Fihdi/LIN/LIN-BOM.csv

Reference | Qty | Value | Footprint
C101,C102 | 2 | 1u | Capacitor_SMD:C_1206_3216Metric
C104,C105 | 2 | 100n | Capacitor_SMD:C_1206_3216Metric
D102,D103 | 2 | 1N4148 | Diode_SMD:D_SOD-323_HandSoldering
D104 | 1 | LED | LED_THT:LED_D5.0mm
J1 | 1 | Conn_02x05_Odd_Even | Connector_IDC:IDC-Header_2x05_P2.54mm_Vertical
J102,J103,J104 | 3 | AudioJack2 | Library:MonoTRS
J105 | 1 | AudioJack3 | Library:StereoTRS
Q101 | 1 | BC857 | Package_TO_SOT_SMD:SOT-23
R5,R13 | 2 | 47k | Resistor_SMD:R_1206_3216Metric
R101,R104 | 2 | 100k | Resistor_SMD:R_1206_3216Metric
R102,R103,R105,R106,R111,R113 | 6 | 1k | Resistor_SMD:R_1206_3216Metric
R108,R109 | 2 | 4k7 | Resistor_SMD:R_1206_3216Metric
R110,R112 | 2 | 500k | Resistor_SMD:R_1206_3216Metric
R114 | 1 | 2k2 | Resistor_SMD:R_1206_3216Metric
RV1,RV2 | 2 | 100k | Potentiometer_THT:Potentiometer_Alpha_RD901F-40-00D_Single_Vertical
U101 | 1 | LM13700 | Package_SO:SOIC-16_3.9x9.9mm_P1.27mm
U102 | 1 | TL072 | Package_SO:SOIC-8_3.9x4.9mm_P1.27mm
