Fihdi/LIN/LIN-AB-Board-BOM.xlsx

 |  |  | LIN AB-Board BOM
Item # | *Designator | *Qty | Manufacturer | *Mfg Part # | Description / Value | *Package/Footprint | Type | Your Instructions / Notes
1 | C101,C102 | 2 |  | C377070 | 1u | Capacitor_SMD:C_1206_3216Metric
2 | C104,C105 | 2 |  | C309030 | 100n | Capacitor_SMD:C_1206_3216Metric
3 | D102,D103 | 2 |  | C917117 | 1N4148 | Diode_SMD:D_SOD-323_HandSoldering
4 | D104 | 1 |  |  | LED | LED_THT:LED_D5.0mm |  | DNP
5 | J1 | 1 |  |  | Conn_02x05_Odd_Even | Connector_IDC:IDC-Header_2x05_P2.54mm_Vertical |  | DNP
6 | J102,J103,J104 | 3 |  |  | AudioJack2 | Library:MonoTRS |  | DNP
7 | J105 | 1 |  |  | AudioJack3 | Library:StereoTRS |  | DNP
8 | Q101 | 1 |  | C148244 | BC857 | Package_TO_SOT_SMD:SOT-23
9 | R5,R13 | 2 |  | C2907507 | 47k | Resistor_SMD:R_1206_3216Metric
10 | R101,R104 | 2 |  | C2907421 | 100k | Resistor_SMD:R_1206_3216Metric
11 | R102,R103,R105,R106,R111,R113 | 6 |  | C131398 | 1k | Resistor_SMD:R_1206_3216Metric
12 | R108,R109 | 2 |  | C2907387 | 4k7 | Resistor_SMD:R_1206_3216Metric
13 | R110,R112 | 2 |  | C2907518 | 560k | Resistor_SMD:R_1206_3216Metric
14 | R114 | 1 |  | C2930413 | 2k2 | Resistor_SMD:R_1206_3216Metric
15 | RV1,RV2 | 2 |  |  | 100k | Potentiometer_THT:Potentiometer_Alpha_RD901F-40-00D_Single_Vertical |  | DNP
16 | U101 | 1 |  | C174050 | LM13700 | Package_SO:SOIC-16_3.9x9.9mm_P1.27mm
17 | U102 | 1 |  | C67473 | TL072 | Package_SO:SOIC-8_3.9x4.9mm_P1.27mm
Need a quick and accurante quote? Need an efficient production? Please read SMT Ordering Necessary Files & Info in 1 minute. Thank you very much!
Click for Instructions on How to Create a BOM (https://www.pcbway.com/blog/PCB_Assembly/How_to_Build_a_BOM__Bill_Of_Materials_.html)
 |  |  |  |  | s
