Fihdi/LIN/LIN-Schematic.pdf

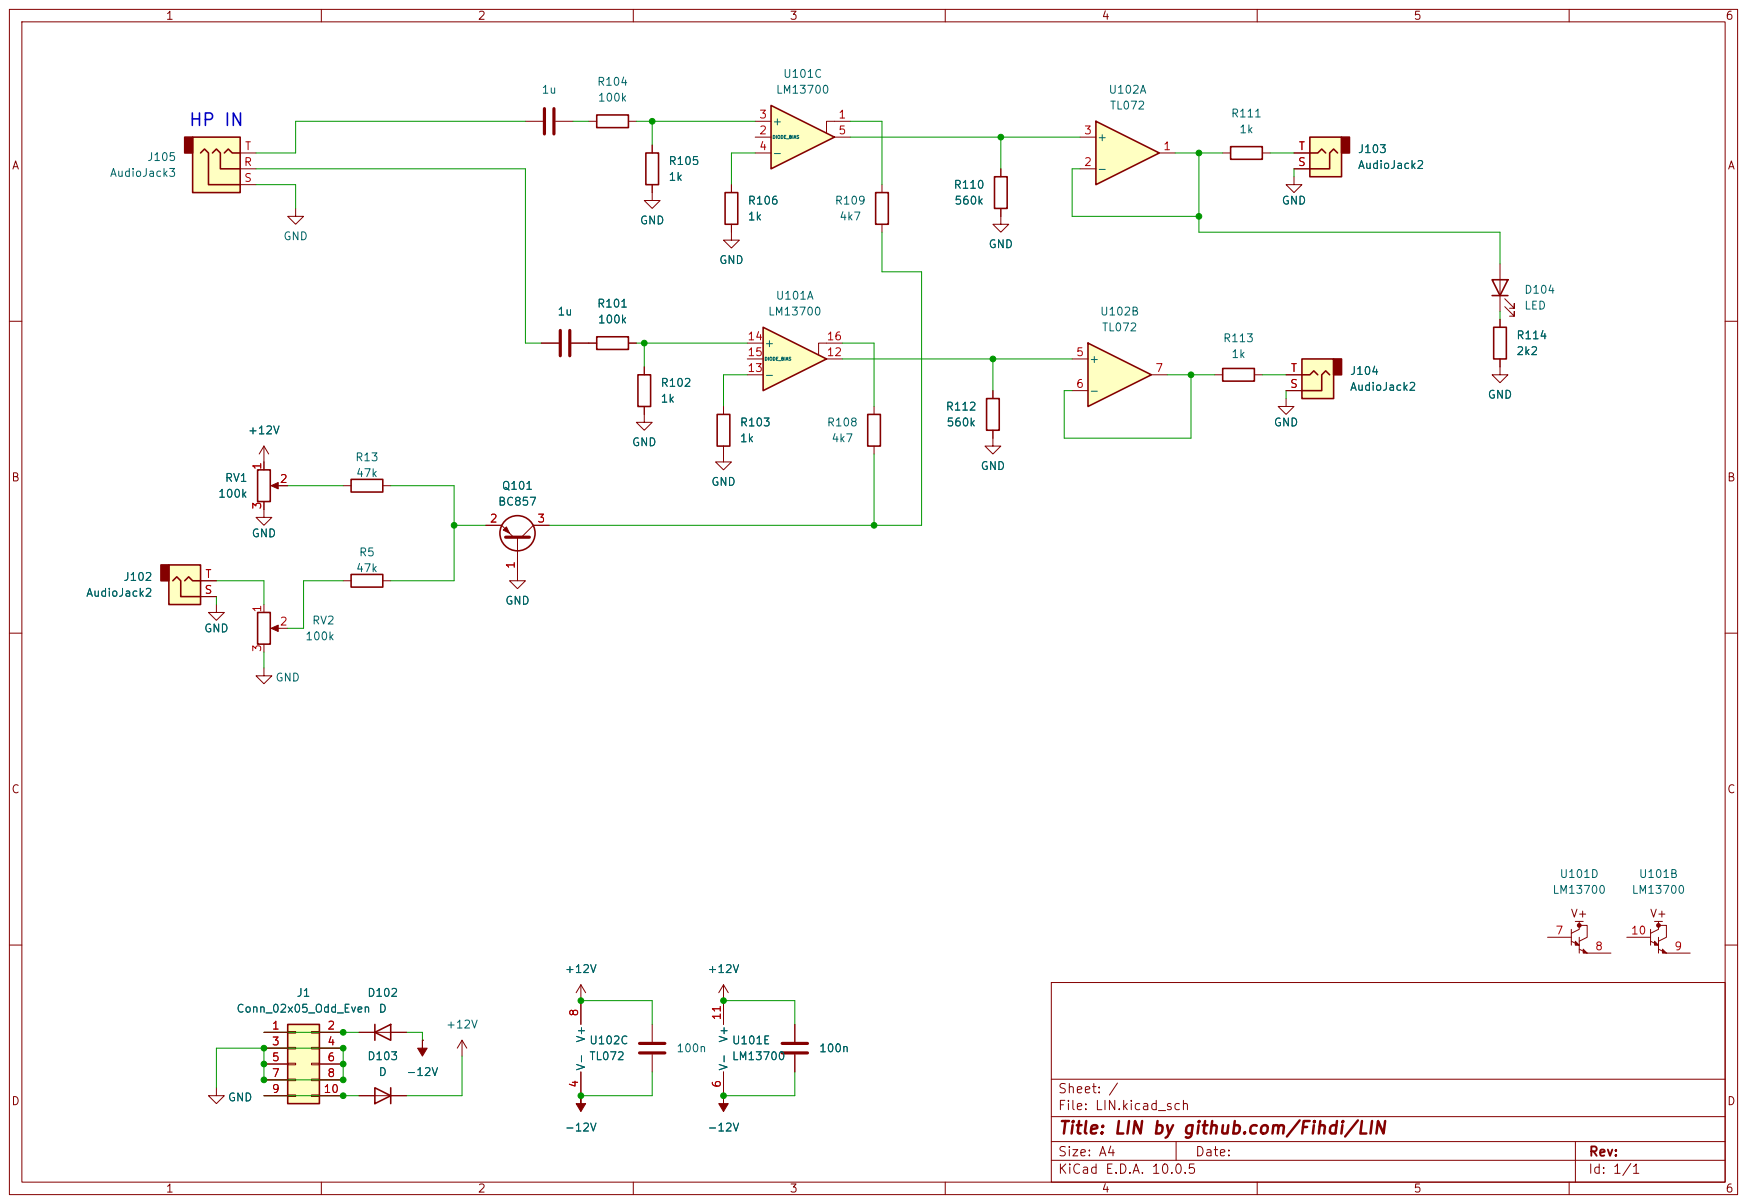
[picture p1: page 1]

5 5 | 6 6
7 7 | 8 8

Sheet: /
File: LIN.kicad_sch
Title: LIN by github.com/Fihdi/LIN

Size: A4 | Rev:
KiCad E.D.A. 10.0.5 | Id: 1/1
