Fihdi/LIN/LIN.kicad_pcb

## KiCad design LIN.kicad_pcb (2026-10-21)

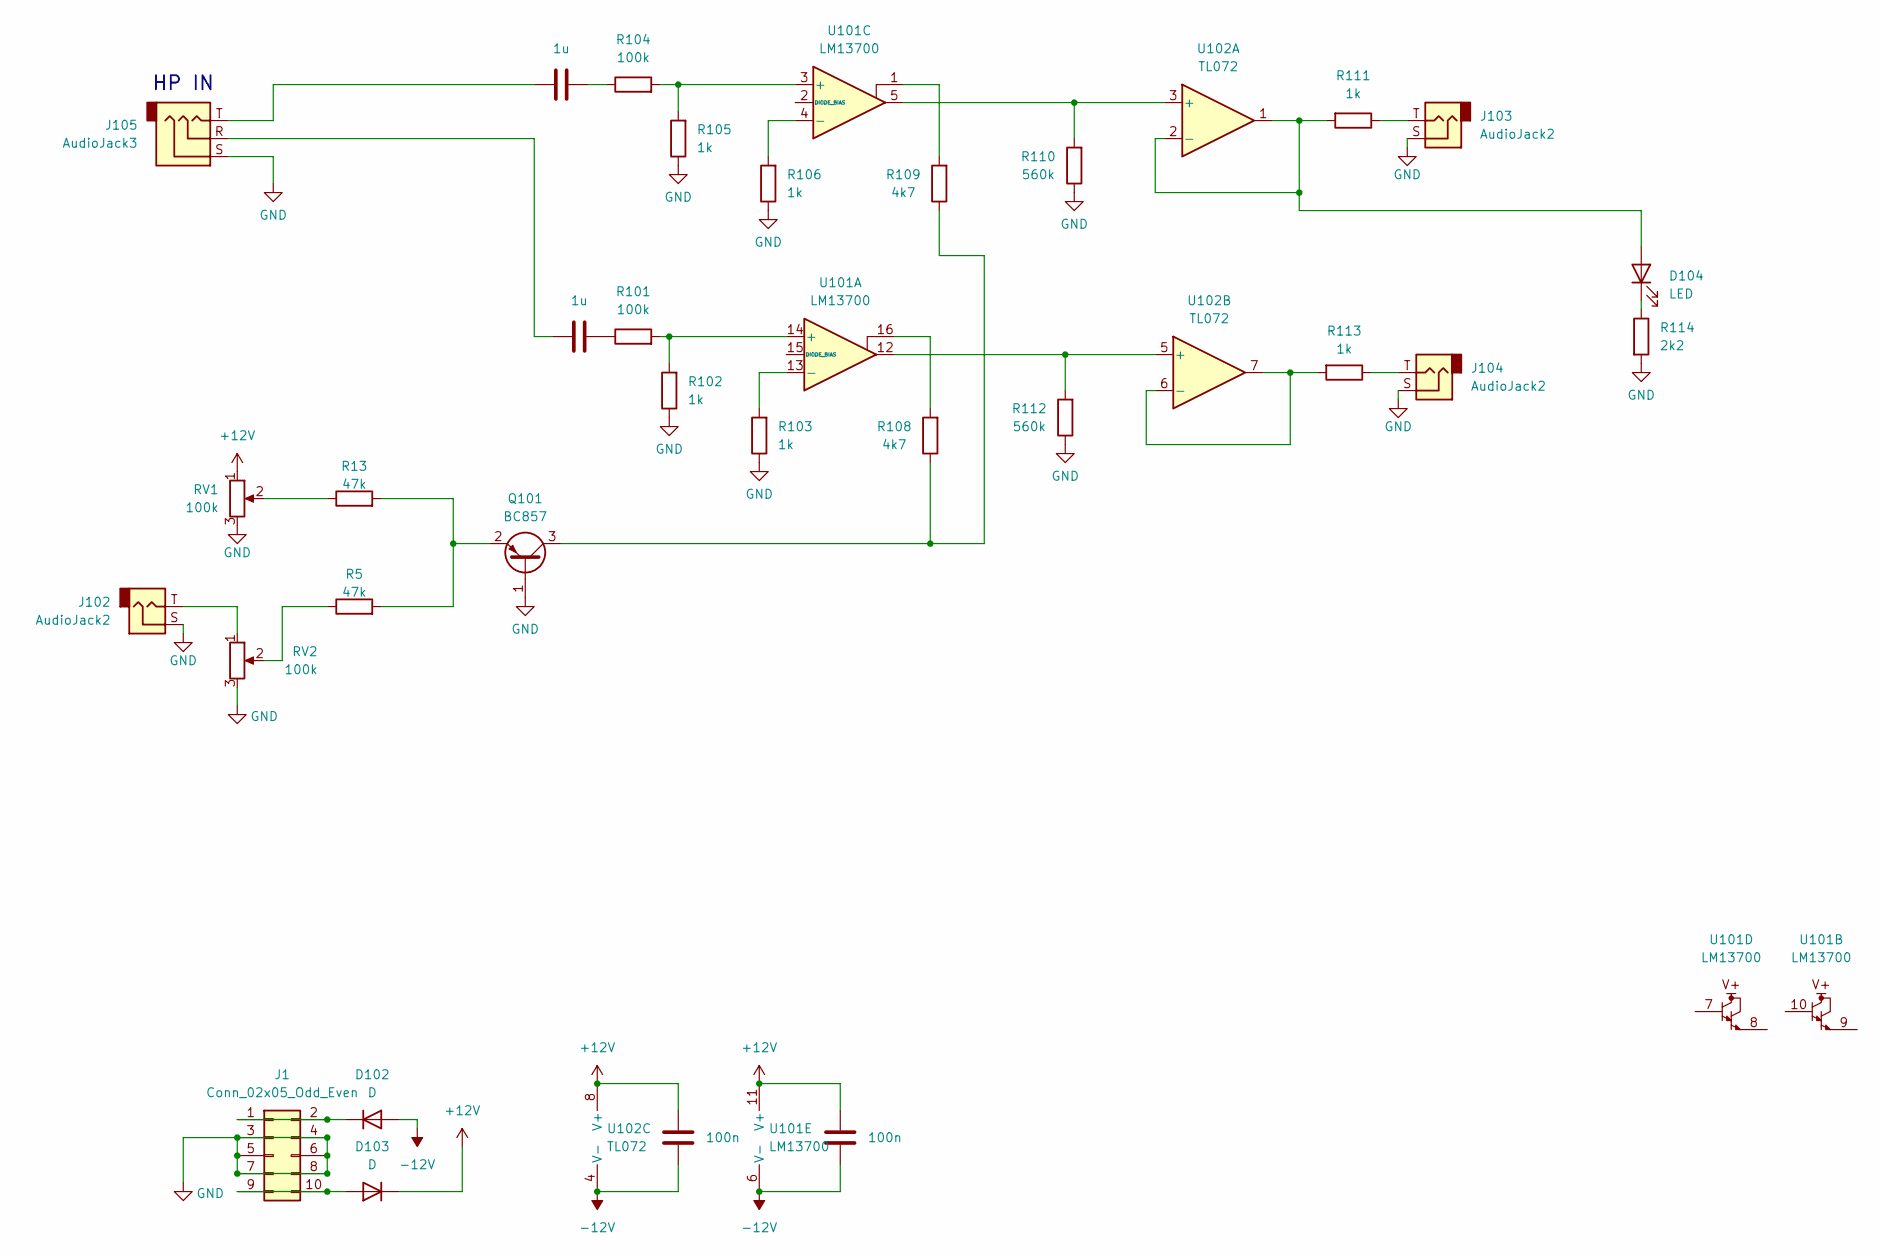
[picture p2: schematic LIN.kicad_sch]

Parts:
C101, C102: 1u; C_1206_3216Metric
C104, C105: 100n; C_1206_3216Metric
D102, D103: D; D_SOD-323_HandSoldering
D104: LED; LED_D5.0mm
J1: Conn_02x05_Odd_Even; IDC-Header_2x05_P2.54mm_Vertical
J102, J103, J104: AudioJack2; MonoTRS
J105: AudioJack3; StereoTRS
Q101: BC857; SOT-23
R5, R13: 47k; R_1206_3216Metric
R101, R104: 100k; R_1206_3216Metric
R102, R103, R105, R106, R111, R113: 1k; R_1206_3216Metric
R108, R109: 4k7; R_1206_3216Metric
R110, R112: 560k; R_1206_3216Metric
R114: 2k2; R_1206_3216Metric
RV1, RV2: 100k; Potentiometer_Alpha_RD901F-40-00D_Single_Vertical
U101: LM13700; SOIC-16_3.9x9.9mm_P1.27mm
U102: TL072; SOIC-8_3.9x4.9mm_P1.27mm

Connections:
+12V: C104.1, C105.1, D103.1 (K), RV1.1, U101.11 (V+), U102.8 (V+)
-12V: C104.2, C105.2, D102.2 (A), U101.6 (V-), U102.4 (V-)
GND: J1.3, J1.4, J1.5, J1.6, J1.7, J1.8, J102.S, J103.S, J104.S, J105.S, Q101.1 (B), R102.1, R103.1, R105.1, R106.1, R110.1, R112.1, R114.2, RV1.3, RV2.3
unnamed: C101.1, R101.1
unnamed: C101.2, J105.R
unnamed: C102.1, R104.1
unnamed: C102.2, J105.T
unnamed: D102.1 (K), J1.1, J1.2
unnamed: D103.2 (A), J1.9, J1.10
unnamed: D104.2 (A), R111.2, U102.1, U102.2 (-)
unnamed: D104.1 (K), R114.1
unnamed: J102.T, RV2.1
unnamed: J103.T, R111.1
unnamed: J104.T, R113.1
unnamed: Q101.3 (C), R108.1, R109.1
unnamed: Q101.2 (E), R5.2, R13.2
unnamed: R5.1, RV2.2
unnamed: R13.1, RV1.2
unnamed: R108.2, U101.16
unnamed: R109.2, U101.1
unnamed: R101.2, R102.2, U101.14 (+)
unnamed: R103.2, U101.13 (-)
unnamed: R104.2, R105.2, U101.3 (+)
unnamed: R106.2, U101.4 (-)
unnamed: R110.2, U101.5, U102.3 (+)
unnamed: R112.2, U101.12, U102.5 (+)
unnamed: R113.2, U102.6 (-), U102.7

Notes on the sheet:
HP IN

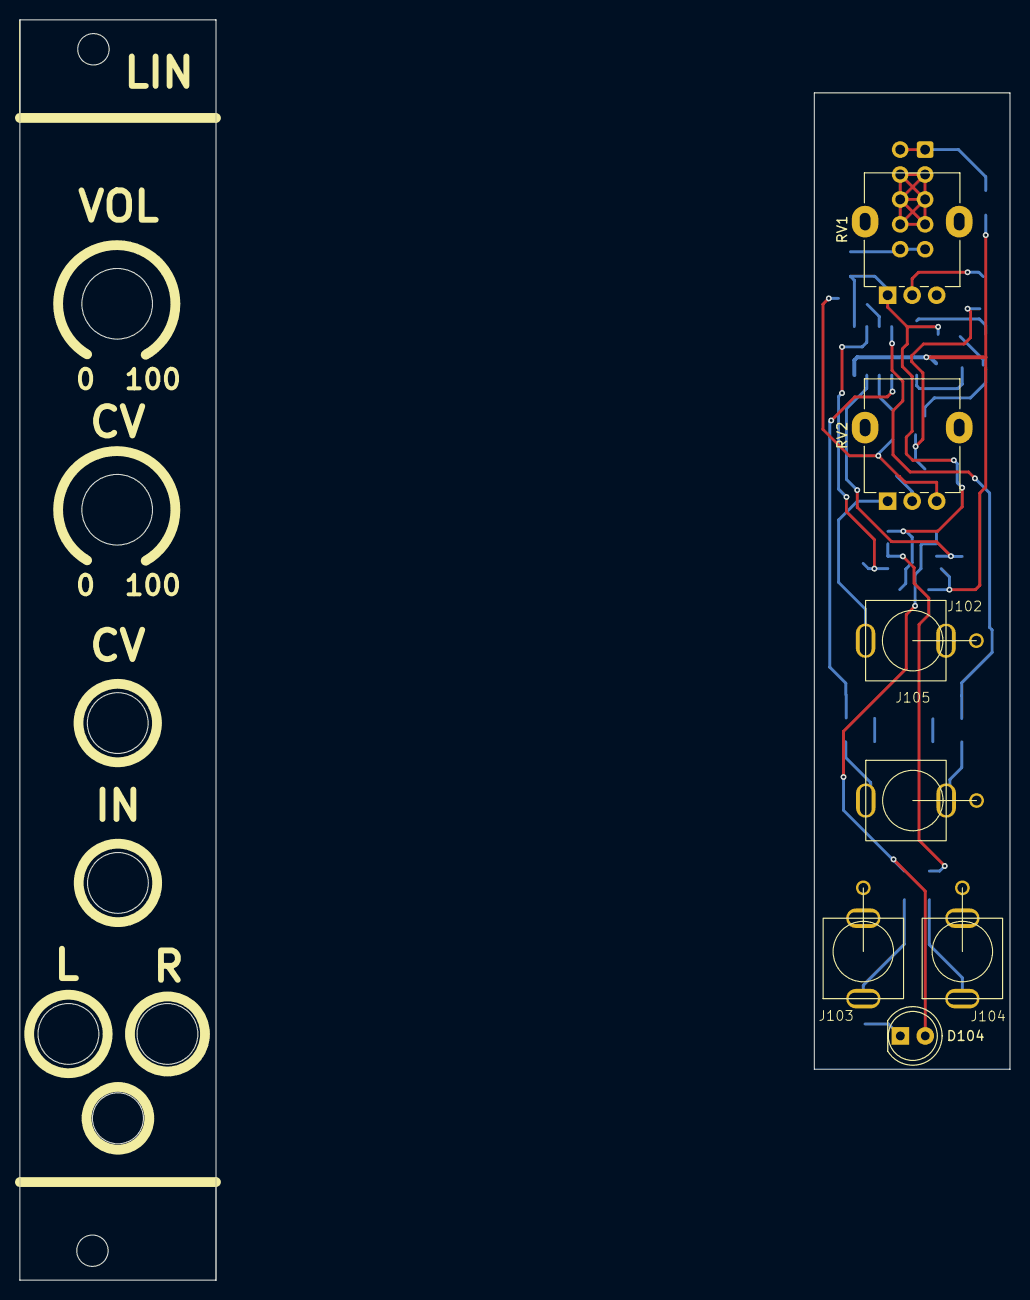
[picture p3: board LIN.kicad_pcb from above]

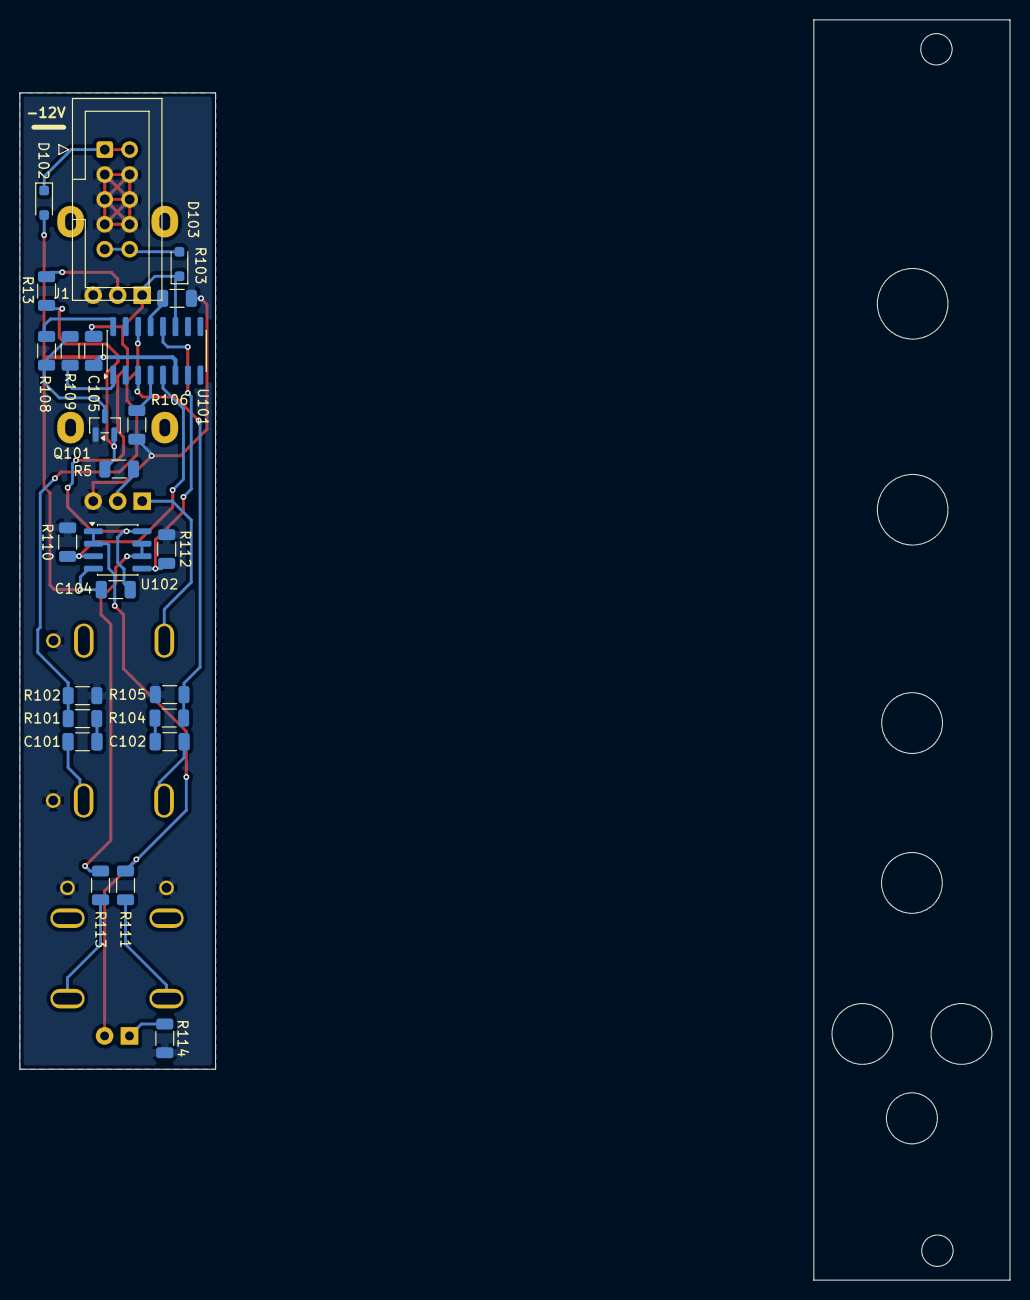
[picture p4: board LIN.kicad_pcb from below]

Board: 2 copper layers, 19.9 x 99.5 mm, 32 parts (25 on the bottom side), 27 nets.
